DigitalNatureGroup/Howland-VCCS-for-GVS-experiment-prototype/schematics/schematic.png

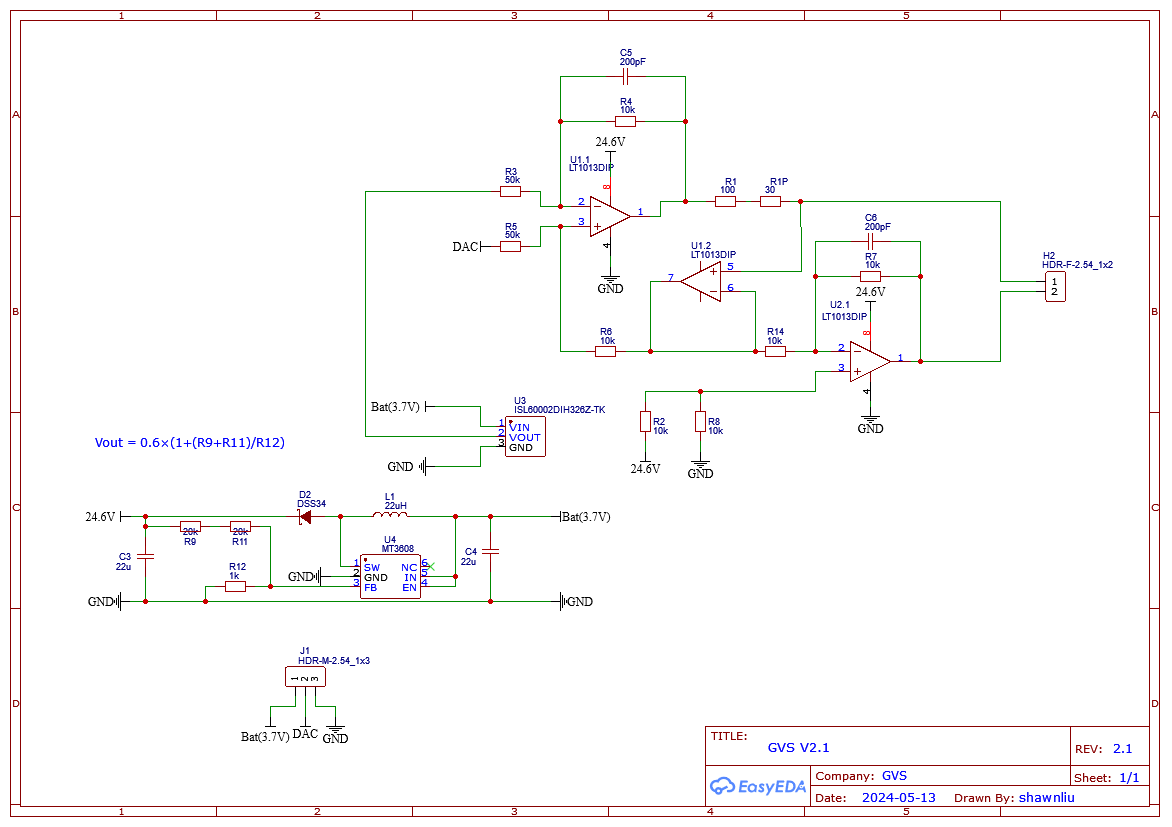
schematics/schematic.png
