DigitalNatureGroup/Howland-VCCS-for-GVS-experiment-prototype/schematics/e1e7952599984f8b88d5fc9924ef2239_1749780990000-JLCPCB Assembly Order.xls

JLCPCB BOM Tool - BOM Matching
BOM name：e1e7952599984f8b88d5fc9924ef2239_1749780990000-JLCPCB Assembly Order.xlsx |  |  | Download Time：2025-06-13 10:28:11 |  |  |  | * Our matching results are updated in real-time, but stock and prices may change. If it's been over 24 hours, please re-match before placing your order.
PCB Assembled Qty：5 |  |  | Est. Total Price：15.5379
Your BOM |  |  |  |  | Matched Parts |  |  |  |  |  |  | Order Information
Top Designator | Bottom Designator | Comment | Footprint | JLCPCB Part # | Matches | Part # | Manufacturer | Footprint | Description | Category | Warning | JLCPCB Part # | Product link | Lib Type | Qty | Source | Total Price ($)
C3,C4 |  | 22u | C0805 |  | Select by Customer | CL21A226MAQNNNE | Samsung Electro-Mechanics | 0805 | 25V 22uF X5R ±20% 0805 Multilayer Ceramic Capacitors MLCC - SMD/SMT ROHS | Multilayer Ceramic Capacitors MLCC - SMD/SMT | 1.The comment (CL21A226MAQNNNE) of this part does not match the one (22u) provided in your BOM. Please confirm; | C45783 | https://jlcpcb.com/partdetail/46786-CL21A226MAQNNNE/C45783 | Basic | 10 | 10 JLCPCB | 0.374
C5,C6 |  | 200pF | C0805 |  | Select by Customer | 0805CG201J500NT | FH (Guangdong Fenghua Advanced Tech) | 0805 | 50V 200pF C0G ±5% 0805 Multilayer Ceramic Capacitors MLCC - SMD/SMT ROHS | Multilayer Ceramic Capacitors MLCC - SMD/SMT |  | C1799 | https://jlcpcb.com/partdetail/2151-0805CG201J500NT/C1799 | Extended | 20 | 20 JLCPCB | 0.154
D2 |  | DSS34 | SOD-123_L2.8-W1.8-LS3.7-RD |  | Select by System | DSS34 | Changzhou Starsea Elec | SOD-123F | 40V 550mV@3A 3A SOD-123F Schottky Diodes ROHS | Schottky Diodes |  | C84632 | https://jlcpcb.com/partdetail/Changzhou_StarseaElec-DSS34/C84632 | Extended | 9 | 9 JLCPCB | 0.5292
H2 |  | HDR-F-2.54_1x2 | HDR-F-2.54_1X2 |  | Select by System | 2.54-1*2P母 | BOOMELE(Boom Precision Elec) | 插件,P=2.54mm | 2.54mm Single Row 2P Direct Insert 1x2P Plugin,P=2.54mm Female Headers ROHS | Female Headers |  | C49661 | https://jlcpcb.com/partdetail/50669-2_54_1_2P/C49661 | Extended | 0 | 0 JLCPCB | 0
J1 |  | HDR-M-2.54_1x3 | HDR-M-2.54_1X3 |  | Select by System | 77311-102-03LF | Amphenol ICC | 插件,P=2.54mm | Tin 3A Direct Insert Policy 2.54mm 3P -65℃~+125℃ 2.54mm Single Row Black Phosphor Bronze Plugin,P=2.54mm Pin Headers ROHS | Pin Headers |  | C180248 | https://jlcpcb.com/partdetail/AmphenolICC-77311_10203LF/C180248 | Extended | 5 | 5 JLCPCB | 0.8955
L1 |  | 22uH | IND-SMD_L7.1-W6.6 |  | Select by System | SMMS0650-220M | SXN(Shun Xiang Nuo Elec) | SMD,6.6x7.1mm | 2.5A 22uH Integrated molded inductor ±20% 4A SMD,6.6x7.1mm Power Inductors ROHS | Power Inductors |  | C149586 | https://jlcpcb.com/partdetail/160920-SMMS0650220M/C149586 | Extended | 6 | 6 JLCPCB | 0.8418
R1 |  | 100 | R0805 |  | Select by Customer | 0805W8F1000T5E | UNI-ROYAL(Uniroyal Elec) | 0805 | 125mW Thick Film Resistors 150V ±100ppm/℃ ±1% 100Ω 0805 Chip Resistor - Surface Mount ROHS | Chip Resistor - Surface Mount | 1.The comment (0805W8F1000T5E) of this part does not match the one (100) provided in your BOM. Please confirm; | C17408 | https://jlcpcb.com/partdetail/18096-0805W8F1000T5E/C17408 | Basic | 5 | 5 JLCPCB | 0.009
R1P |  | 30 | R0805 |  | Select by Customer | AR05BTCW0300 | Viking Tech | 0805 | 125mW Thin Film Resistor 100V ±25ppm/℃ ±0.1% 30Ω 0805 Chip Resistor - Surface Mount ROHS | Chip Resistor - Surface Mount | 1.The comment (AR05BTCW0300) of this part does not match the one (30) provided in your BOM. Please confirm; | C316206 | https://jlcpcb.com/partdetail/VikingTech-AR05BTCW0300/C316206 | Extended | 13 | 13 JLCPCB | 0.5187
R2,R4,R6,R7,R8,R14 |  | 10k | R0805 |  | Select by Customer | 0805W8F1002T5E | UNI-ROYAL(Uniroyal Elec) | 0805 | 125mW Thick Film Resistors 150V ±100ppm/℃ ±1% 10kΩ 0805 Chip Resistor - Surface Mount ROHS | Chip Resistor - Surface Mount | 1.The comment (0805W8F1002T5E) of this part does not match the one (10k) provided in your BOM. Please confirm; | C17414 | https://jlcpcb.com/partdetail/18102-0805W8F1002T5E/C17414 | Basic | 30 | 30 JLCPCB | 0.051
R3,R5 |  | 50k | R0805 |  | Select by Customer | CR0805F84992G | LIZ Elec | 0805 | 125mW Thick Film Resistors 150V ±100ppm/℃ ±1% 49.9kΩ 0805 Chip Resistor - Surface Mount ROHS | Chip Resistor - Surface Mount | 1.The comment (CR0805F84992G) of this part does not match the one (50k) provided in your BOM. Please confirm; | C101762 | https://jlcpcb.com/partdetail/LIZElec-CR0805F84992G/C101762 | Extended | 20 | 20 JLCPCB | 0.044
R9,R11 |  | 20k | R0805 |  | Select by Customer | 0805W8F2002T5E | UNI-ROYAL(Uniroyal Elec) | 0805 | 125mW Thick Film Resistors 150V ±100ppm/℃ ±1% 20kΩ 0805 Chip Resistor - Surface Mount ROHS | Chip Resistor - Surface Mount | 1.The comment (0805W8F2002T5E) of this part does not match the one (20k) provided in your BOM. Please confirm; | C4328 | https://jlcpcb.com/partdetail/4735-0805W8F2002T5E/C4328 | Basic | 10 | 10 JLCPCB | 0.018
R12 |  | 1k | R0805 |  | Select by Customer | 0805W8F1001T5E | UNI-ROYAL(Uniroyal Elec) | 0805 | 125mW Thick Film Resistors 150V ±100ppm/℃ ±1% 1kΩ 0805 Chip Resistor - Surface Mount ROHS | Chip Resistor - Surface Mount | 1.The comment (0805W8F1001T5E) of this part does not match the one (1k) provided in your BOM. Please confirm; | C17513 | https://jlcpcb.com/partdetail/18201-0805W8F1001T5E/C17513 | Basic | 5 | 5 JLCPCB | 0.0085
U3 |  | ISL60002DIH326Z-TK | SOT-23-3_L2.9-W1.3-P1.90-LS2.4-BR |  | Select by Customer | ISL60002DIH326Z-TK | RENESAS | SOT-23-3 | Fixed 7mA 20ppm/℃ 2.8V~5.5V series connection -40℃~+85℃@(Ta) 2.6V SOT-23-3 Voltage Reference | Voltage Reference |  | C152385 | https://jlcpcb.com/partdetail/RENESAS-ISL60002DIH326ZTK/C152385 | Extended | 5 | 5 JLCPCB | 11.565
U4 |  | MT3608 | SOT-23-6_L2.9-W1.6-P0.95-LS2.8-BL |  | Select by System | MT3608 | XI'AN Aerosemi Tech | SOT-23-6 | Boost type 28V 2V~24V SOT-23-6 DC-DC Converters ROHS | DC-DC Converters |  | C84817 | https://jlcpcb.com/partdetail/XI_AN_AerosemiTech-MT3608/C84817 | Extended | 9 | 9 JLCPCB | 0.5292
U1,U2 |  | LT1013DIP | PDIP-8_L9.6-W6.4-P2.54-LS7.6-BL |  | Select by System | LT1013DIP | Texas Instruments | PDIP-8 | Dual channel 15nA 1MHz PDIP-8 Operational Amplifier ROHS | Operational Amplifier |  | C1346127 | https://jlcpcb.com/partdetail/TexasInstruments-LT1013DIP/C1346127 | Extended | 10 | 0 JLCPCB | 0
