DigitalNatureGroup/Howland-VCCS-for-GVS-experiment-prototype/Compact_design_GVS_prototype.pdf

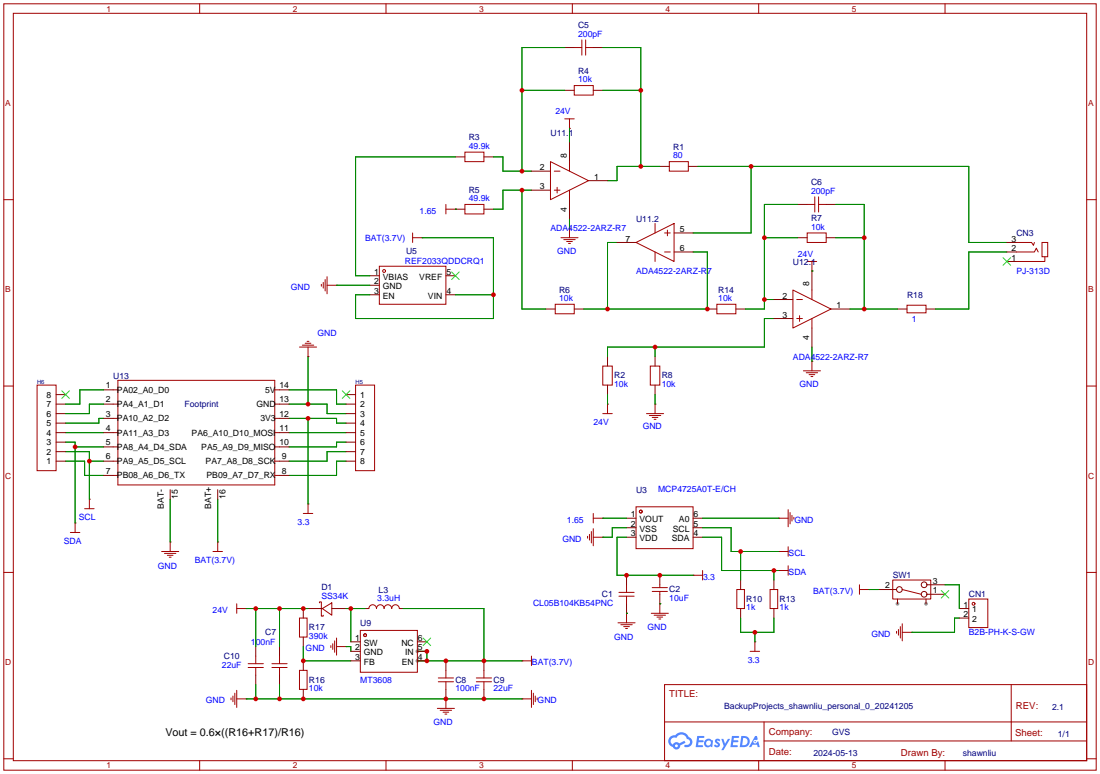
[picture p2: page 1]
