DigitalNatureGroup/Howland-VCCS-for-GVS-experiment-prototype/(commit log)

2024-08-06 Update README.md
    Adding explanation of the calibration process
2024-12-23 Demo codes using Unity and Arduino
2025-04-03 Version Update
    This is the schematics of the update version (2.0); This update primarily focuses on integrating the necessary components into a single printed circuit board (PCB), making it extra compact and easy for maintenance. The fundamental electrical principles remain largely unchanged. For detailed information, please refer to the paper:
    Liu, Zhi and Suzuki, Shieru and Fushimi, Tatsuki and Ochiai, Yoichi, Voltage Controlled Howland Current Source for Galvanic Vestibular Stimulation. Available at SSRN: https://ssrn.com/abstract=5101503 or http://dx.doi.org/10.2139/ssrn.5101503
    Due to the potential risks associated with the use of the GVS device, please ensure that the device is fun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
2025-06-11 Add files via upload
    Adding the CPL file of the device version 1.3 (The Journal version: Design and evaluation of a voltage-controlled current source for galvanic vestibular stimulation research)
    [PickAndPlace_PCB_GVS-V2.1_3_2024-06-26.csv]
2025-06-13 Add files via upload
    Reference for PCB Assembly
    [e1e7952599984f8b88d5fc9924ef2239_1749780990000-JLCPCB Assembly Order.xls]
